Hobbesdcc/RobotArm/Media/Arm.png

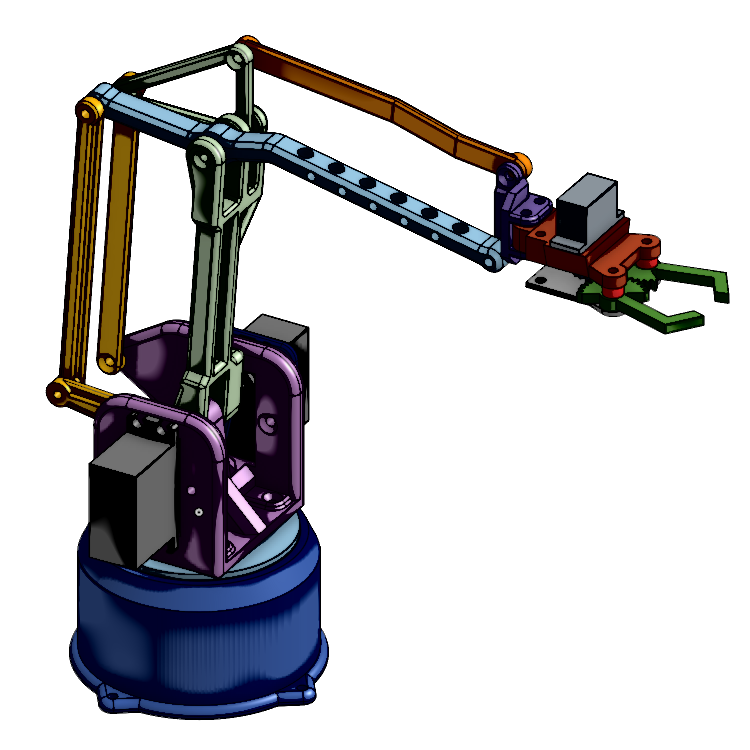
Media/Arm.png
