Hobbesdcc/RobotArm/(commit log)

2021-04-21 add what Arduino Controls and HMI WinForms projects
2021-04-21 Added serial cmd strings, and new buttons for them
2021-04-21 Message system almost working
    broke cpp files up into smaller files
    added some buttons on hmi for get state and mode
    Parse cmds started on Arduino side
    [main.cpp]
2021-04-22 Fixed bugs with the sent command being processed again by the hmi
    [main.cpp]
2021-04-27 short on ram added "F()" to Serial.println lines, seems to work
    the internet says i might be short on ram with all theses strings? things where getting cut off.
    [main.cpp]
2021-04-27 Homing working as expected
2021-04-27 Added Attached/detached buttons and fiction to make them work
2021-04-27 Added Up and Down buttons on HMI for Manual GOTO pos
2021-04-27 Added Check buttons, Issue CMD on Click & Big steps
2021-04-28 Added New Servo for Gripper, and Open/Close function in manual
2021-04-28 Moved Servo Open/Close Gripper commands to fuction
2021-04-29 Goto commands working from script, working script flow
2021-04-29 Fix Script reset button
2021-04-30 added Pin output for power relay, need to test
2021-04-30 tested gripper and power relay, works well
2021-04-30 Added App icon, offset calibrate values
